sudo-apt-install-tap/HackPad-V4/README.md

<div align="center">

Screenshot_20261011_231851-removebg-preview

<h1>
  <b>
    HackPad v4
  </b> 
</h1>

<h3> <b> A 9 Keys, Per-Key RGB with a 0.91" OLED Macropad! </b> </h3>

</div>

## **Overview**

A Macropad With **8** Keys addressable per key RGB and an OLED module

### Why?

My old macropad doesn't get used that often and I cant keep track of all the 16 keys. Thus this will be a more compact build for me and hopefully I will be able to integrate this fully into my system.

also because SCREEN WITH CLIKIES

### How?
Use the firmware in [FIRMWARE](firmware) . This is my first time using QMK and I'm proud of my work because this is much more efficient than circuitpy running KMK.

## CAD
CAD files are available at [CAD](https://cad.onshape.com/documents/d76080119db72d3389085b9f/w/6c29cdd82ab150742e4f6482/e/dc89bac09447832fc9f2681d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)

## Images
<div align="center">
  


<br> Full render<br>

---



<br> PCB

---


<br> Sch

---


<br> 3D Viewer

---

</div>

## BOM

| Part | What it's for | Qty | Unit | Total | Vendor |
| --- | --- | --- | --- | --- | --- |
| [PCB](https://jlcpcb.com/) | Printed circuit board | 1 | $5.00 | $5.00 | [JLCPCB](https://jlcpcb.com/) |
| [Gateron Milky PRO Switch – 5pin](https://meckeys.com/shop/accessories/keyboard-accessories/key-switches/gateron-mechanical-pro-switch-5pin/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) | Switches that THOCC | 1 | $2.50 | $2.50 | [MecKeys](https://meckeys.com/shop/accessories/keyboard-accessories/key-switches/gateron-mechanical-pro-switch-5pin/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) |
| [Blank DSA Keycaps (1u) [Pack of 5]](https://meckeys.com/shop/accessories/keyboard-accessories/keycaps/blank/blank-dsa-keycaps-1u/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) | Keycaps | 2 | $1.25 | $2.50 | [MecKeys](https://meckeys.com/shop/accessories/keyboard-accessories/keycaps/blank/blank-dsa-keycaps-1u/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) |
| [Seeed Studio XIAO RP2040 v1.0](https://robu.in/product/seeed-studio-xiao-rp2040-v1-0/) | MCU | 1 | $6.00 | $6.00 | [Robu.in](https://robu.in/product/seeed-studio-xiao-rp2040-v1-0/) |
| [0.91 inch 128x32 Blue OLED Display Module with I2C/IIC Serial Interface](https://robu.in/product/blue-oled-display-module/) | 2.32cm(0.91inch) I2C/IIC Blue Color OLED Display Module offers 128×32 pixel resolution. | 1 | $2.00 | $2.00 | [Robu.in](https://robu.in/product/blue-oled-display-module/) |
| [1N4148W-7-F-Diodes Incorporated-100V Independent Type 1.25V@150mA 4ns 300mA SOD-123 Switching Diodes ROHS](https://robu.in/product/1n4148w-7-f-diodes-incorporated-100v-independent-type-1-25v150ma-4ns-300ma-sod-123-switching-diodes-rohs/) | Diodes | 20 | $0.03 | $0.60 | [Robu.in](https://robu.in/product/1n4148w-7-f-diodes-incorporated-100v-independent-type-1-25v150ma-4ns-300ma-sod-123-switching-diodes-rohs/) |
| [sk6812 mini-e](https://robu.in/product/1n4148w-7-f-diodes-incorporated-100v-independent-type-1-25v150ma-4ns-300ma-sod-123-switching-diodes-rohs/) | Backlight | 9 | $0.00 | $0.00 | [self sourced](https://robu.in/product/1n4148w-7-f-diodes-incorporated-100v-independent-type-1-25v150ma-4ns-300ma-sod-123-switching-diodes-rohs/) |
| [Print legion](https://hackclub.slack.com/archives/C083P4FJM46/p1791742458204589) | Case 3d printing | 1 | $6.40 | $6.40 | [Print Legion](https://hackclub.slack.com/archives/C083P4FJM46/p1791742458204589) |
| **Parts subtotal** | — | — | — | **$25.00** | — |
| **Tax & shipping** | — | — | — | **$5.00** | — |
| **Total** | — | — | — | **$30.00** | — |
