sudo-apt-install-tap/HackPad-V4/cad/Assembled.step

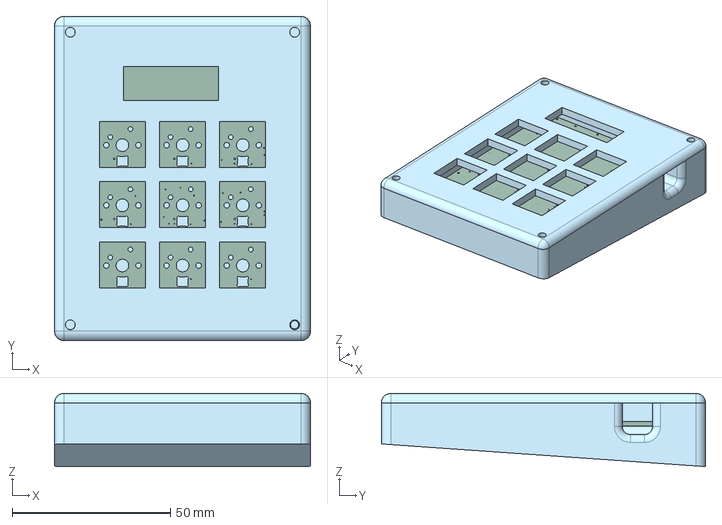
[picture p1: CAD file, 2026-10-11]
cad/Assembled.step
81.0 x 102.6 x 23.2 mm
pcb-unsaved-export-Syf1UI_PCB
