sudo-apt-install-tap/HackPad-V4/pcb/pcb.step

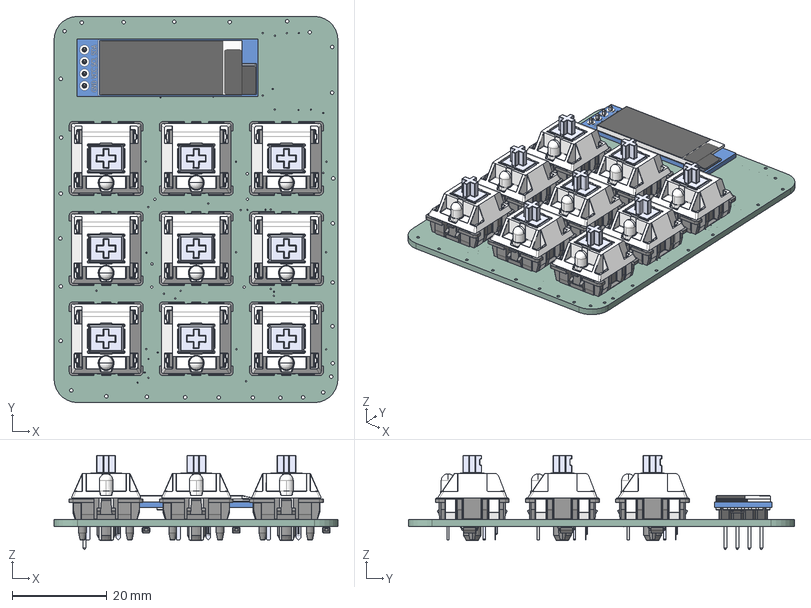
[picture p2: CAD file, 2026-10-11]
pcb/pcb.step
60.0 x 81.6 x 20.0 mm
Bottom x 9
Pulsador x 9
Top x 9
Pieza5^Cherry MX x 9
Pin1 x 9
Pin2 x 9
Led 3mm_trans x 9
OLED_0.91_128x32
Pin Header 4 x 1 TH 2.54mm Pitch
RESC-0603 x 13
2SD0601A
D_SOD-123 x 9
pcb-unsaved-export-Syf1UI_PCB
