sudo-apt-install-tap/HackPad-V4/cad/Case[HackPadV4].step

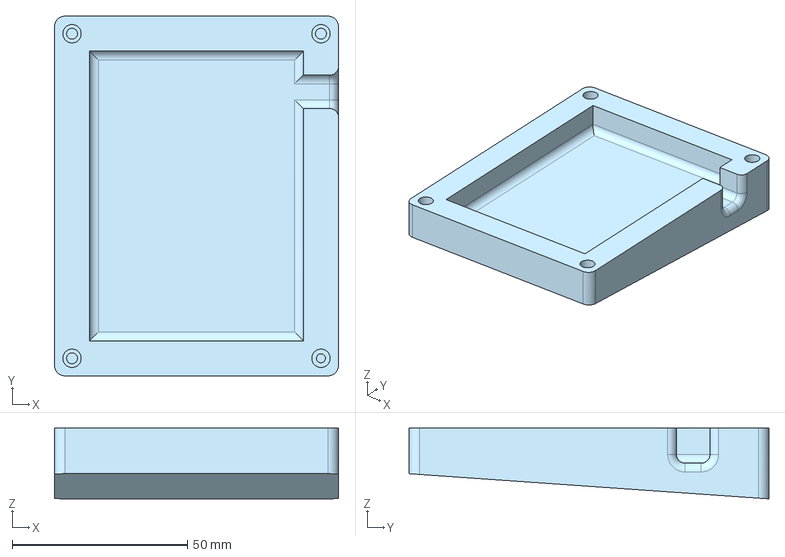
[picture p3: CAD file, 2026-10-11]
cad/Case[HackPadV4].step
81.0 x 102.6 x 20.2 mm
