sudo-apt-install-tap/HackPad-V4/cad/Plate[HackPadV4].step

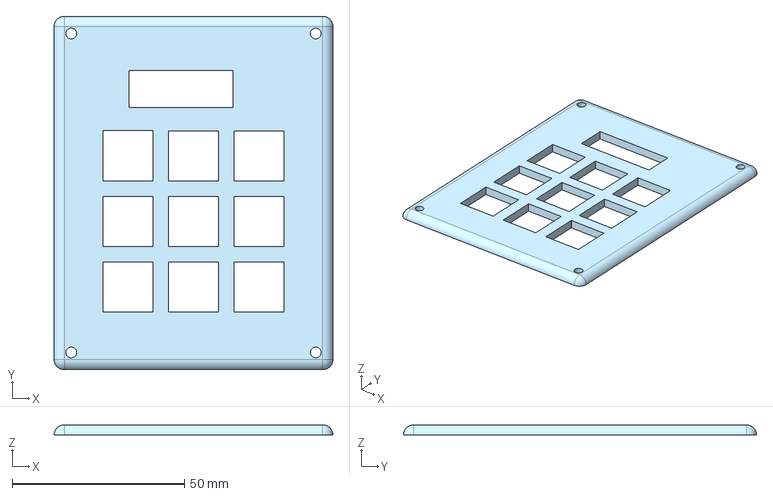
[picture p4: CAD file, 2026-10-11]
cad/Plate[HackPadV4].step
81.0 x 102.6 x 3.00 mm
