sudo-apt-install-tap/HackPad-V4/pcb/pcb.kicad_pcb

## KiCad design pcb/pcb.kicad_pcb (2026-10-17)

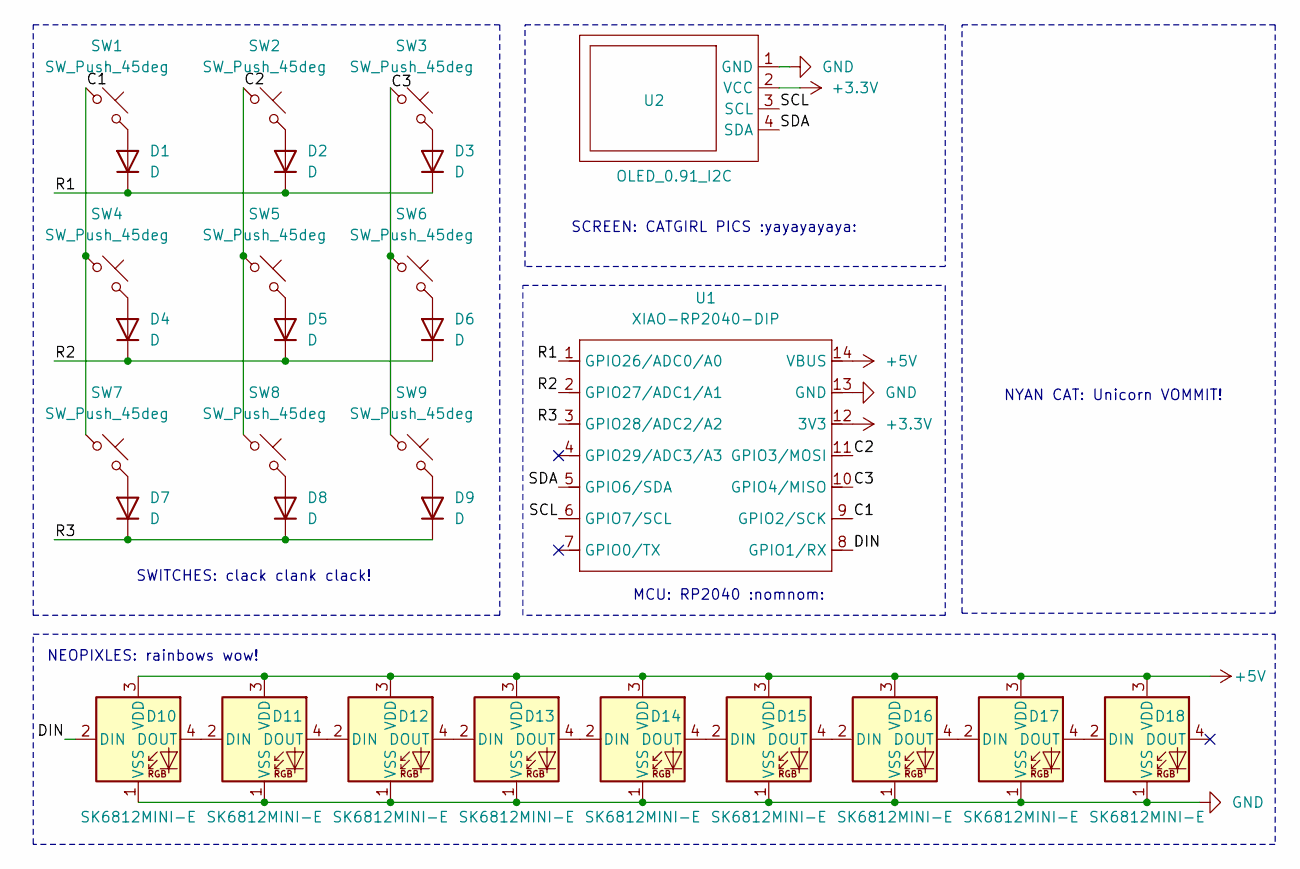
[picture p5: schematic pcb.kicad_sch]

Parts:
D1, D2, D3, D4, D5, D6, D7, D8, D9: D; D_SOD-123
D10, D11, D12, D13, D14, D15, D16, D17, D18: SK6812MINI-E; MX_SK6812MINI-E
SW1, SW2, SW3, SW4, SW5, SW6, SW7, SW8, SW9: SW_Push_45deg; SW_Cherry_MX_PCB
U1: XIAO-RP2040-DIP; XIAO-RP2040-SMD
U2: OLED_0.91_I2C; PinSocket_1x04_P2.54mm_Vertical

Connections:
+3.3V: U1.12 (3V3), U2.2 (VCC)
+5V: D10.3 (VDD), D11.3 (VDD), D12.3 (VDD), D13.3 (VDD), D14.3 (VDD), D15.3 (VDD), D16.3 (VDD), D17.3 (VDD), D18.3 (VDD), U1.14 (VBUS)
/C1: SW1.1, SW4.1, SW7.1, U1.9 (GPIO2/SCK)
/C2: SW2.1, SW5.1, SW8.1, U1.11 (GPIO3/MOSI)
/C3: SW3.1, SW6.1, SW9.1, U1.10 (GPIO4/MISO)
/DIN: D10.2 (DIN), U1.8 (GPIO1/RX)
/R1: D1.1 (K), D2.1 (K), D3.1 (K), U1.1 (GPIO26/ADC0/A0)
/R2: D4.1 (K), D5.1 (K), D6.1 (K), U1.2 (GPIO27/ADC1/A1)
/R3: D7.1 (K), D8.1 (K), D9.1 (K), U1.3 (GPIO28/ADC2/A2)
/SCL: U1.6 (GPIO7/SCL), U2.3 (SCL)
/SDA: U1.5 (GPIO6/SDA), U2.4 (SDA)
GND: D10.1 (VSS), D11.1 (VSS), D12.1 (VSS), D13.1 (VSS), D14.1 (VSS), D15.1 (VSS), D16.1 (VSS), D17.1 (VSS), D18.1 (VSS), U1.13 (GND), U2.1 (GND)
unnamed: D1.2 (A), SW1.2
unnamed: D2.2 (A), SW2.2
unnamed: D3.2 (A), SW3.2
unnamed: D4.2 (A), SW4.2
unnamed: D5.2 (A), SW5.2
unnamed: D6.2 (A), SW6.2
unnamed: D7.2 (A), SW7.2
unnamed: D8.2 (A), SW8.2
unnamed: D9.2 (A), SW9.2
unnamed: D10.4 (DOUT), D11.2 (DIN)
unnamed: D11.4 (DOUT), D12.2 (DIN)
unnamed: D12.4 (DOUT), D13.2 (DIN)
unnamed: D13.4 (DOUT), D14.2 (DIN)
unnamed: D14.4 (DOUT), D15.2 (DIN)
unnamed: D15.4 (DOUT), D16.2 (DIN)
unnamed: D16.4 (DOUT), D17.2 (DIN)
unnamed: D17.4 (DOUT), D18.2 (DIN)

Notes on the sheet:
NYAN CAT: Unicorn VOMMIT!
SWITCHES: clack clank clack!
SCREEN: CATGIRL PICS :yayayayaya:
NEOPIXLES: rainbows wow!
MCU: RP2040 :nomnom:

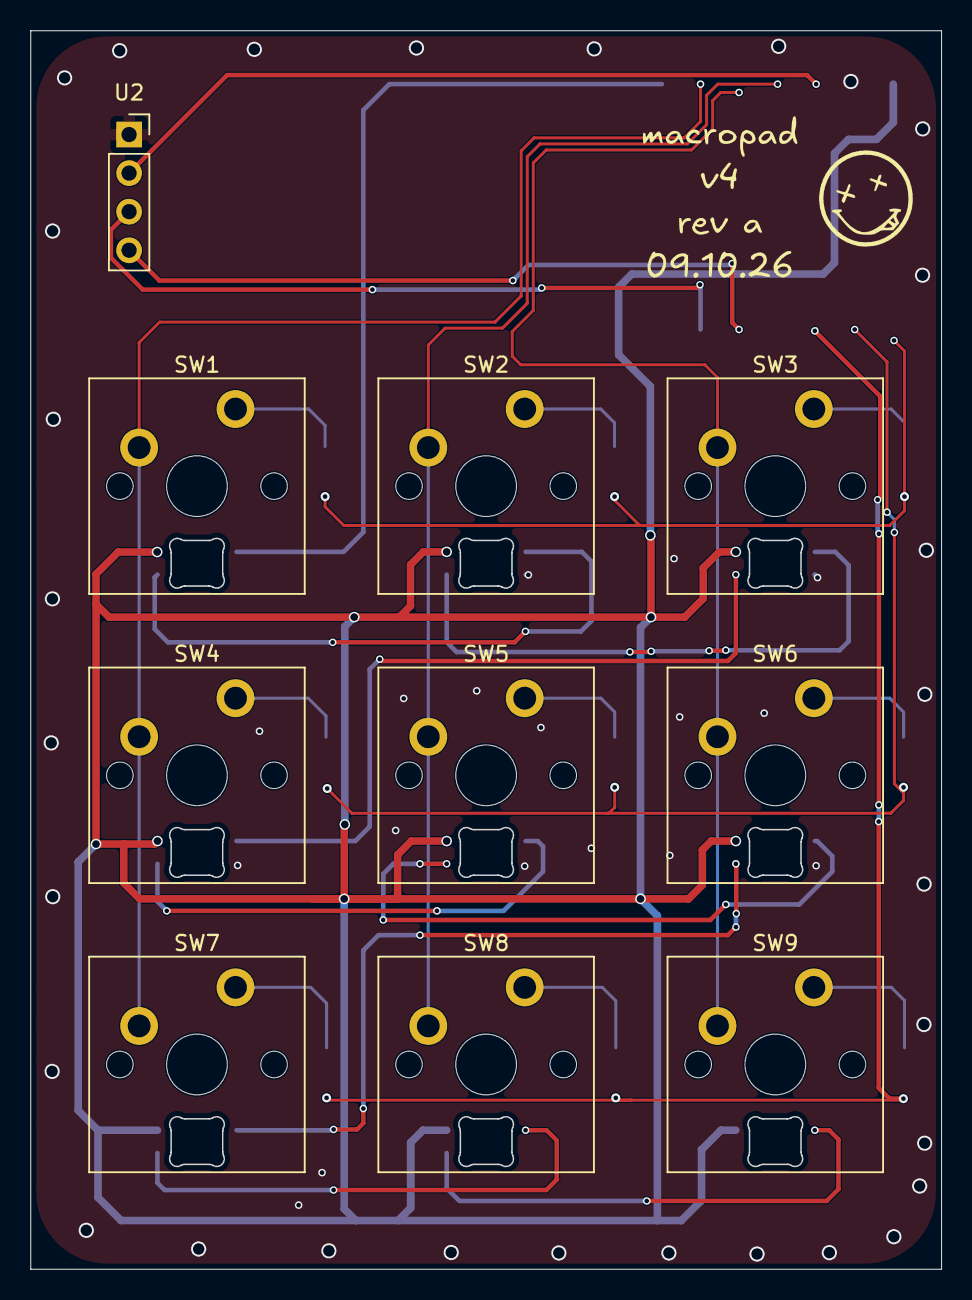
[picture p6: board pcb.kicad_pcb from above]

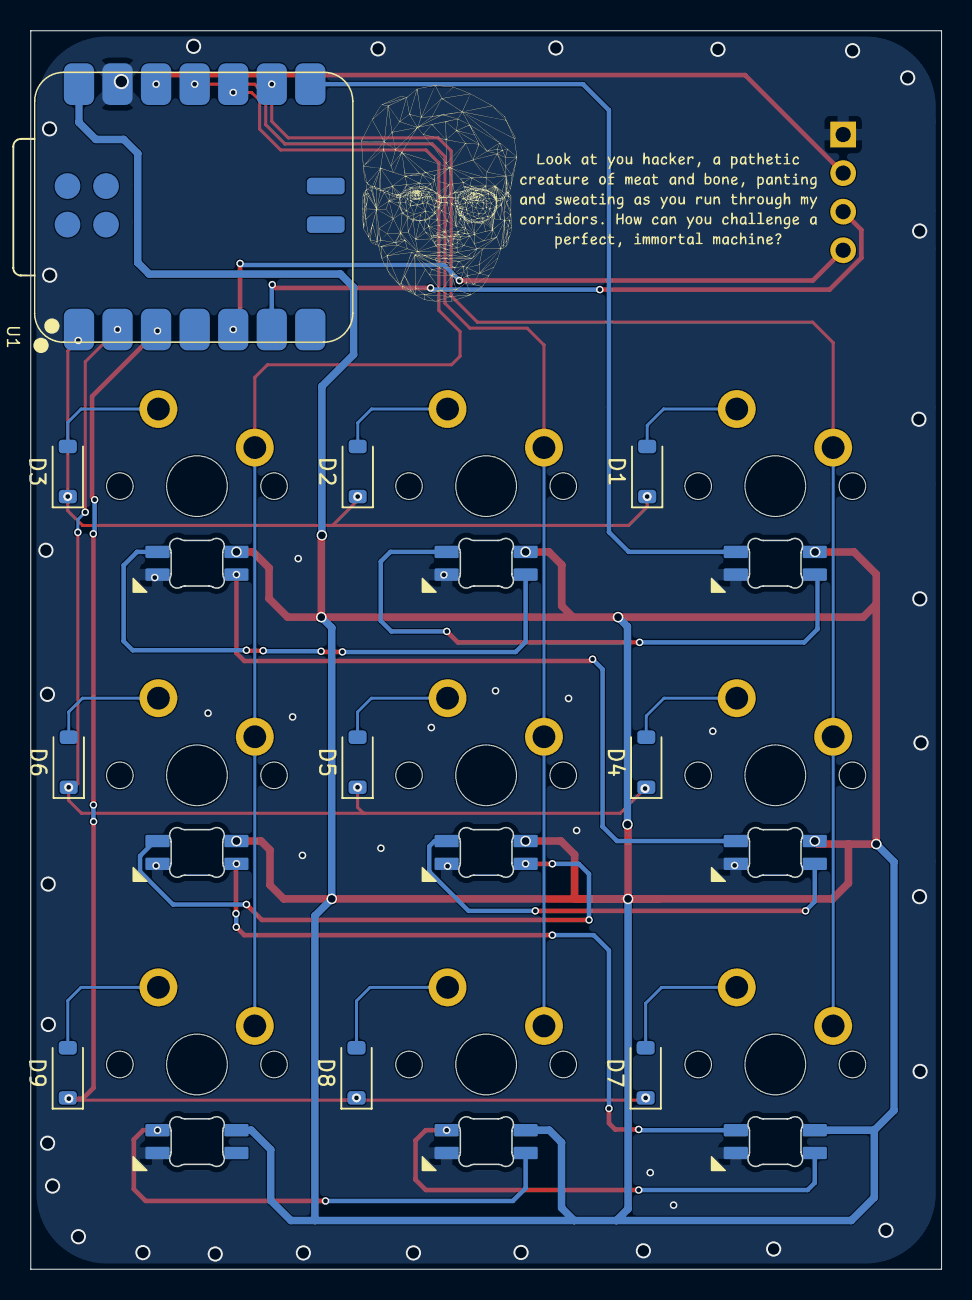
[picture p7: board pcb.kicad_pcb from below]

Board: 2 copper layers, 60.0 x 81.6 mm, 29 parts (10 on the bottom side), 29 nets.
