sudo-apt-install-tap/HackPad-V4/JOURNAL.md

# Macropad with cool screen! – devlog

<!-- Generated by Half Life from project cmuxznbxi01od01ng9v69z82s. Edits here are overwritten on the next sync. -->
<!-- Generated: 2026-10-11T12:05:56.239Z -->

> [!NOTE]
> This devlog is mirrored from [Half Life](https://halflife.hackclub.com). Editing it here will not change the platform's copy, and the next sync overwrites this file.

> A basic(ish macropad)

| Week | Tier | Hours logged | Entries |
| --- | --- | --- | --- |
| Week 1 | Tier 1 | 18h | 5 |

## Contents

1. [2026-10-07 – # SO!! I MADE A VERY CUTE-SY Schematic today!!](#2026-10-07-so-i-made-a-very-cute-sy-schematic-today)
2. [2026-10-08 – Did layout and completed routing!](#2026-10-08-did-layout-and-completed-routing)
3. [2026-10-09 – # Art and DRC: A match made in the deepest corners of hell](#2026-10-09-art-and-drc-a-match-made-in-the-deepest-corners-o)
4. [2026-10-10 – # Case: CADing time!](#2026-10-10-case-cading-time)
5. [2026-10-11 – # Code and CAD Finishing: laying the last bricks.](#2026-10-11-code-and-cad-finishing-laying-the-last-bricks)

## Design

### 2026-10-07 – # SO!! I MADE A VERY CUTE-SY Schematic today!!

**3h**

# SO!! I MADE A VERY CUTE-SY Schematic today!!

Well it is cute and functional!

This will be my new and improved macropad, my forth design from scratch!

Features Of This Hackpad:-

+ 9 keys(not too many not too less)
+ 0.91" OLED
+ Backlighting with sk6812 mini-e
+ XIAO RP2060 based









### 2026-10-08 – Did layout and completed routing!

**4h**

Did layout and completed routing!

So I finally did the routing of the macropad it was pretty easy, for the ground pour i just had to pop a few grounding via to connect disconnected parts of the ground plane and it was done!

It was easy enough though i had to design my own iteration of the sk6812 mini-e footprint to fit the LCSC documentation.  Next up is DRC and some silkscreen art!!









### 2026-10-09 – # Art and DRC: A match made in the deepest corners of hell

**3.5h**

# Art and DRC: A match made in the deepest corners of hell

- ART IS DONE!!

I added some cool silkscreen art and text, hope that it turns out looking good. There were some silkscreen clipping warnings but usually JLCPCB takes care of them.









- DRC was *okay*?

OKAY I DONT KNOW HOW THIS HAPPNED!!! DRCS WERE MOSTLY **OKAY**.

It just had the standard errors of the pads being too close to the holes of the neopixle which is honestly not a biggie as it is a problem with the footprint itself and i cant be bothered to fix it as it still works.

```
If it works don't touch it!
```



- Whats next?

I still need to do the CAD and the programming of the mcu itself, im thinking about qmk but ive only used kmk before. An adventure does sound nice!

### 2026-10-10 – # Case: CADing time!

**3.5h**

# Case: CADing time!

- A design guide for semi-complex plates in-case you wanna do the same process

Well keyboard layout editor is good for most macropads and keyboards. But the way that i make my plate is pretty different.

Delete all of the routing, ground pour and most of the components(diodes, MCU & neopixles)



 Keep the components that require a cut out.



Draw 14.2mm squares around all the mx switches. For displays follow [this image](https://www.winstar.com.tw/uploads/editor/images/oled-module/graphic-oled-display/WEA012832F.jpg)  and figure out the dimensions according to your liking. P.S: These shapes should be in edge.cut layer. Delete the components. Now it should looks something like this:



Now we have to export this! Follow these steps:





Now use this DXF file in your cad to get the plate!

- Case is done and dusted!

It was easy enough I added 1mm clearance to each side, added an angel of 4deg to make using it easier. Added screw holes for m3 screws and inserts. Now it looks like this!









### 2026-10-11 – # Code and CAD Finishing: laying the last bricks.

**4h**

# Code and CAD Finishing: laying the last bricks.

- QMK is not *that* bad?

YES I TRIED QMK! Well it was pretty easy to do given the benefits that it has over KMK.

The hardest part was probably the setup itself. I used the CLI instead of the GUI for the keymaps because I am built different.

It went easy enough then, i just had to compile it and yeah it was a pleasant enough experience. Would do this again!

- CAD: The 2nd last brick.

I added the mx keys and the oled display STEP parts in KiCAD. This is the final product!







-  Github: One less nightmare to go!

So I did all the work that was required on github and yeah everything looks okay. This will be the end of this journal log
