sudo-apt-install-tap/HackPad-V4/qmk/config.h

#pragma once

#define WS2812_DI_PIN GP1
#define RGBLIGHT_LED_COUNT 9

#define I2C_DRIVER I2CD1
#define I2C1_SDA_PIN GP6
#define I2C1_SCL_PIN GP7

#define OLED_DISPLAY_128X32
#define OLED_TIMEOUT 60000
