sudo-apt-install-tap/HackPad-V4/(commit log)

2026-06-15 Finished PCB
    [pcb.kicad_pcb]
2026-06-15 Add journal entry for completed PCB project
    Documented completion of PCB project using KiCAD10 with images.
2026-10-09 Updated the PCB files
    [pcb.kicad_pcb, pcb.kicad_sch]
2026-10-11 Added qmk source files, compiled firmware and CAD files
2026-10-11 Add BOM.csv with component details and pricing
